janelia-experimental-technology/Rodent-Cylindrical-Treadmill/V1 STYROFOAM TREADMILL/Part Models and Drawings/J010497 CT DRIVE SHAFT Rev -.stp

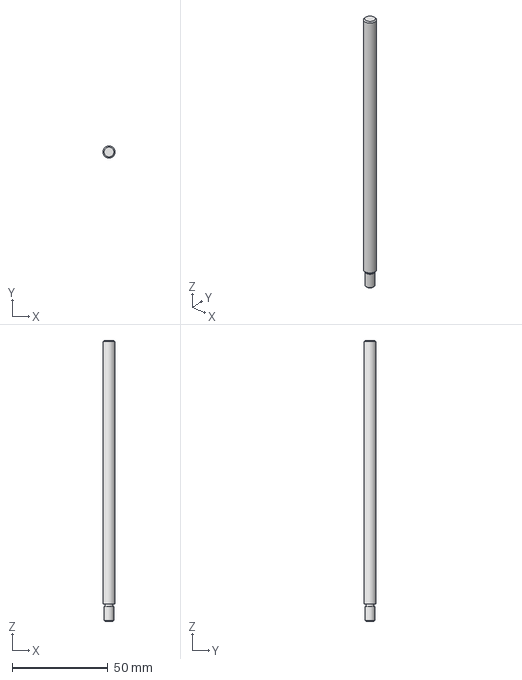
[picture p3: CAD file, 2026-11-08]
V1 STYROFOAM TREADMILL/Part Models and Drawings/J010497 CT DRIVE SHAFT Rev -.stp
6.34 x 6.35 x 146.8 mm
