janelia-experimental-technology/Rodent-Cylindrical-Treadmill/V2 METAL PRINTED TREADMILL/PART MODELS AND DRAWINGS/J010826 CT 9723T11_AI Rev -.stp

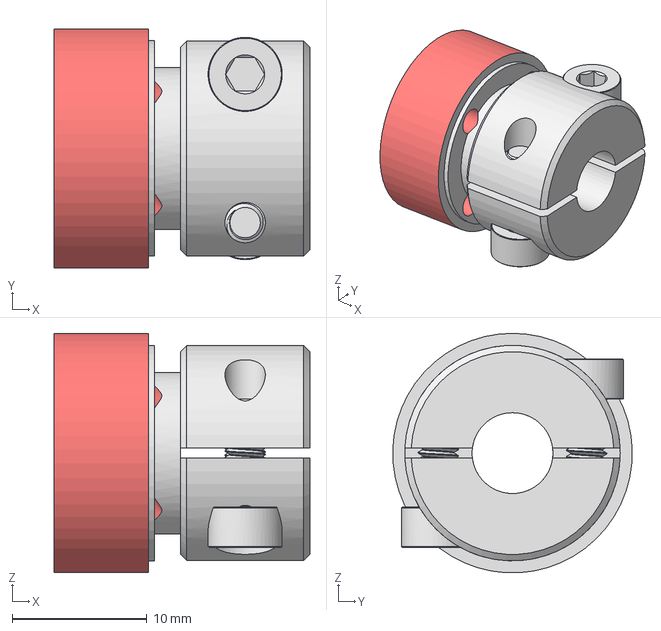
[picture p4: CAD file, 2026-11-08]
V2 METAL PRINTED TREADMILL/PART MODELS AND DRAWINGS/J010826 CT 9723T11_AI Rev -.stp
19.0 x 17.8 x 17.8 mm
