janelia-experimental-technology/Rodent-Cylindrical-Treadmill/V1 STYROFOAM TREADMILL/Part Models and Drawings/J010768 QUICK SWAP CT MOUNT PLATE Rev -.stp

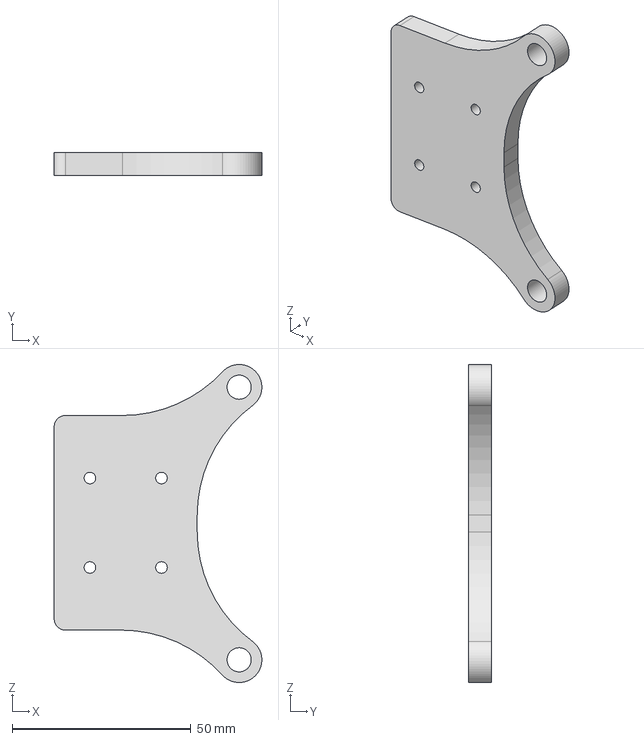
[picture p6: CAD file, 2024-11-06]
V1 STYROFOAM TREADMILL/Part Models and Drawings/J010768 QUICK SWAP CT MOUNT PLATE Rev -.stp
58.1 x 6.35 x 88.9 mm
