janelia-experimental-technology/Rodent-Cylindrical-Treadmill/V1 STYROFOAM TREADMILL/Part Models and Drawings/J010514 CT FOAM WHEEL Rev -.stp

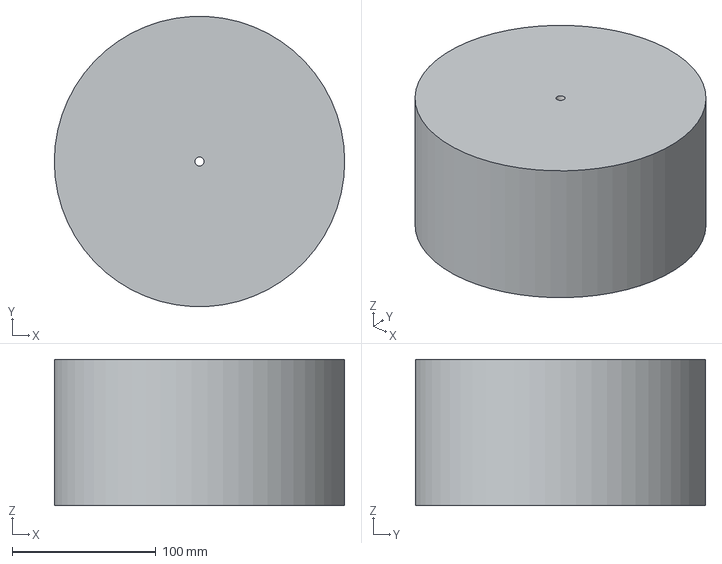
[picture p7: CAD file, 2024-11-05]
V1 STYROFOAM TREADMILL/Part Models and Drawings/J010514 CT FOAM WHEEL Rev -.stp
201.9 x 201.6 x 101.6 mm
