janelia-experimental-technology/Rodent-Cylindrical-Treadmill/(list of files, cad)

Other CAD files:
V2 METAL PRINTED TREADMILL/ASSEMBLY MODELS AND DRAWINGS/CT MPRINTED QUICK SWAP XZ ADJUST.stp
V1 STYROFOAM TREADMILL/Part Models and Drawings/J010764 CT WIDE SIDE PLATE Rev -.stp
V1 STYROFOAM TREADMILL/Part Models and Drawings/J010764 CT WIDE SIDE PLATE Rev -.dxf
V1 STYROFOAM TREADMILL/Part Models and Drawings/J010768 QUICK SWAP CT MOUNT PLATE Rev -.dxf
