janelia-experimental-technology/Rodent-Cylindrical-Treadmill/V2 METAL PRINTED TREADMILL/PART MODELS AND DRAWINGS/J010826 CT 9723T11_AI Rev -.pdf

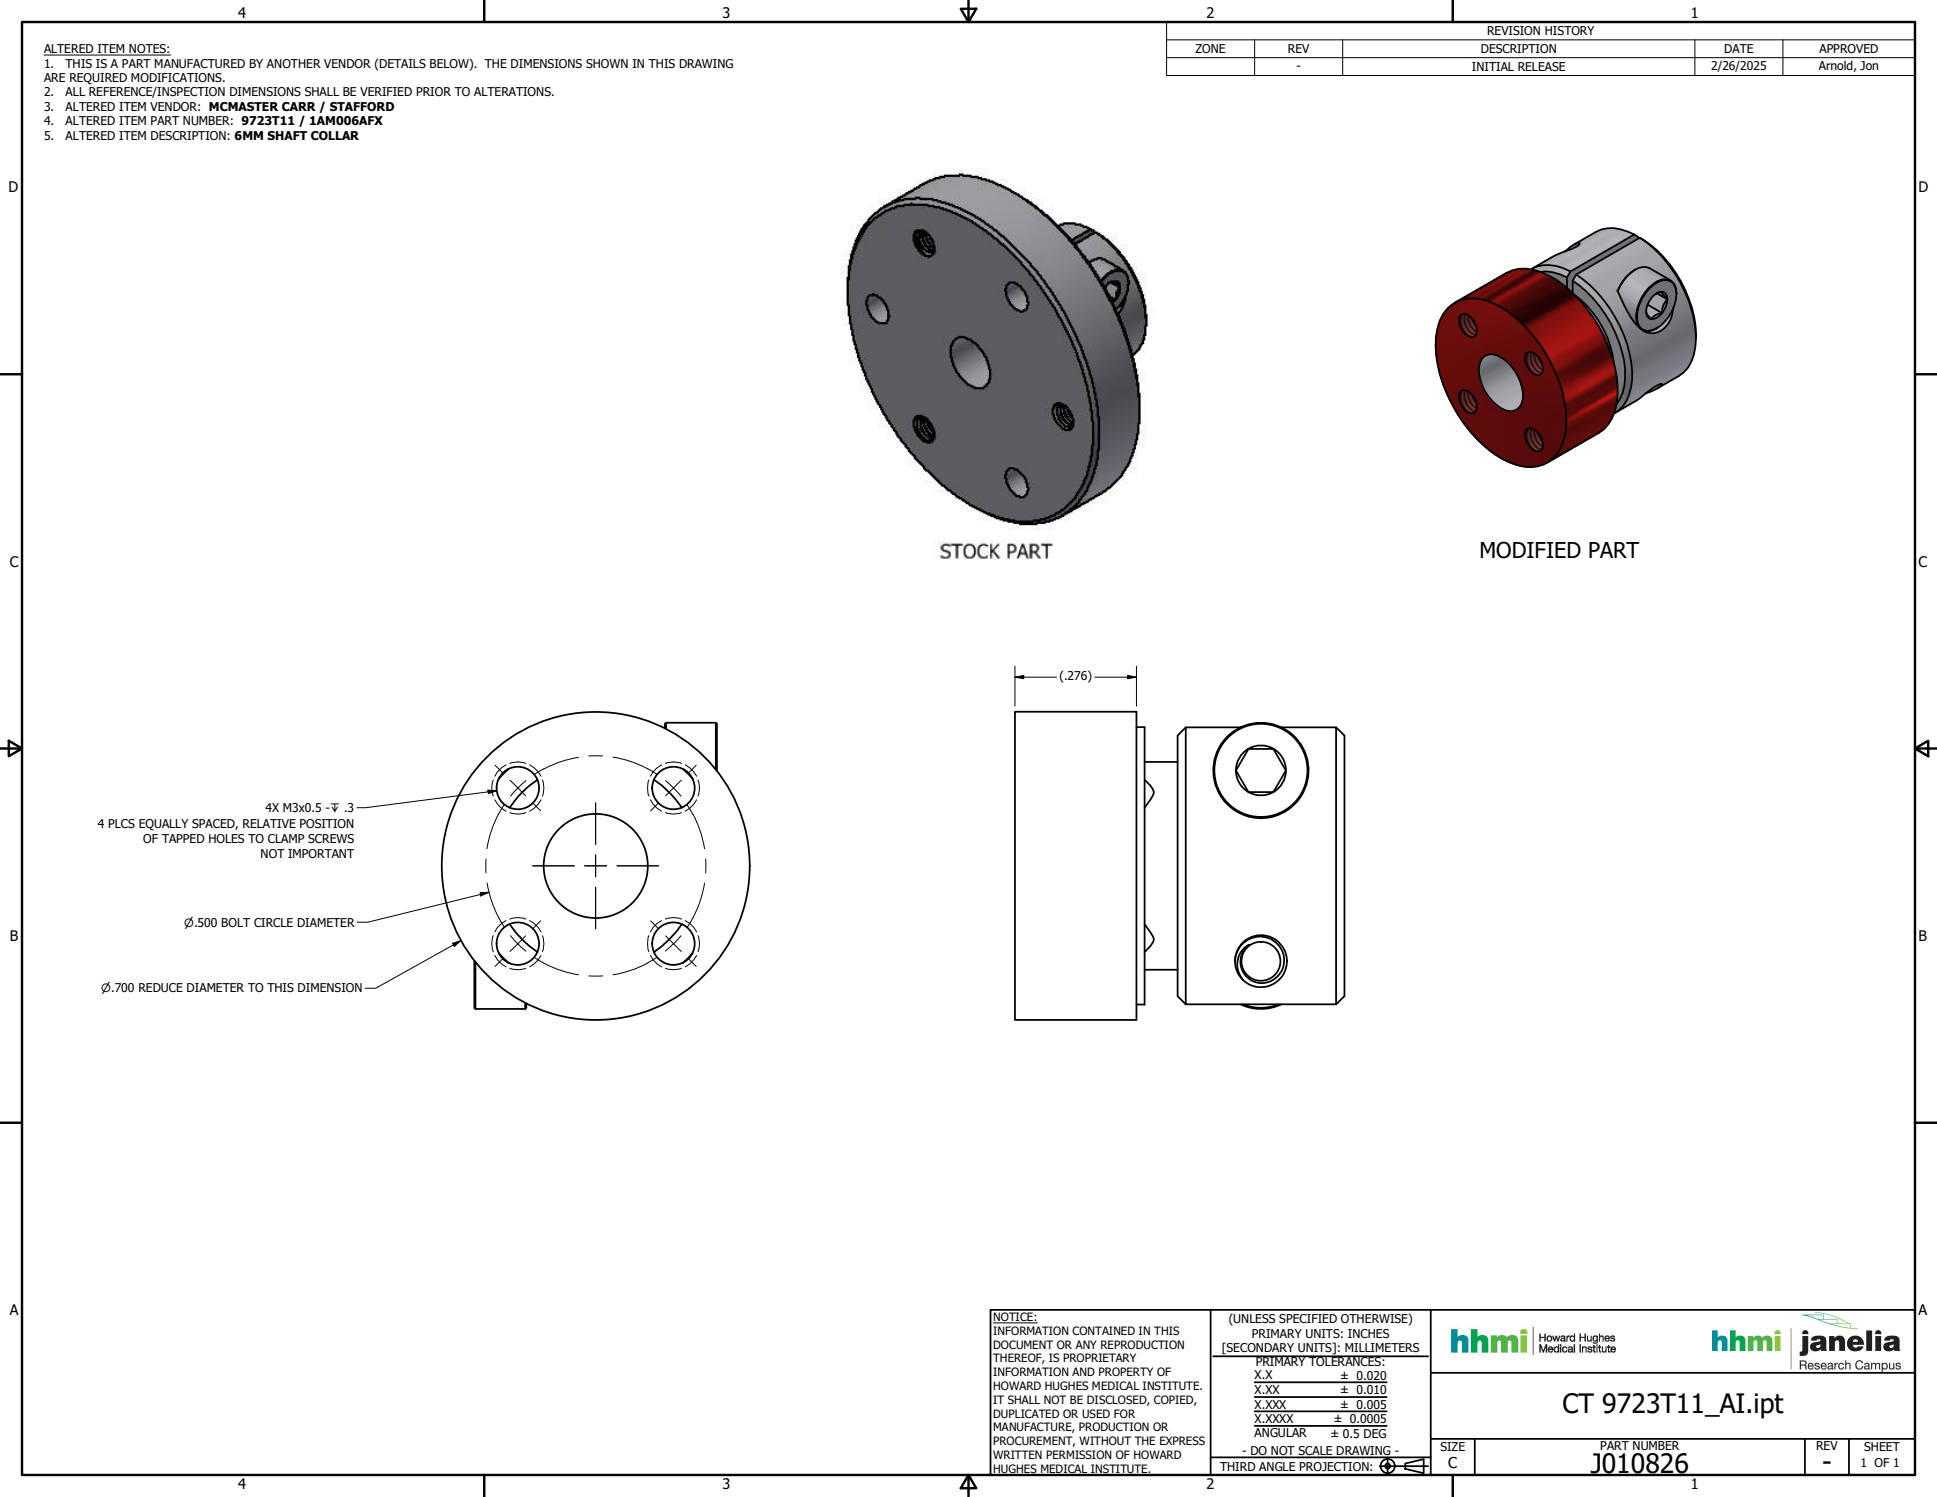
[picture p8: page 1]
MODIFIED PART; PART NUMBER; 1 OF 1 THIRD ANGLE PROJECTION:; ± 0.020 ± 0.010 ± 0.005 ± 0.0005 ± 0.5 DEG; CT 9723T11_AI.ipt; REVISION HISTORY; NOT IMPORTANT

ALTERED ITEM NOTES:
1. THIS IS A PART MANUFACTURED BY ANOTHER VENDOR (DETAILS BELOW). THE DIMENSIONS SHOWN IN THIS DRAWING
ARE REQUIRED MODIFICATIONS.
2. ALL REFERENCE/INSPECTION DIMENSIONS SHALL BE VERIFIED PRIOR TO ALTERATIONS.
3. ALTERED ITEM VENDOR: MCMASTER CARR / STAFFORD
4. ALTERED ITEM PART NUMBER: 9723T11 / 1AM006AFX
5. ALTERED ITEM DESCRIPTION: 6MM SHAFT COLLAR

ZONE | REV | DESCRIPTION | DATE | APPROVED

- | INITIAL RELEASE | 2/26/2025 | Arnold, Jon

4 PLCS EQUALLY SPACED, RELATIVE POSITION

OF TAPPED HOLES TO CLAMP SCREWS

⌀.500 BOLT CIRCLE DIAMETER

⌀.700 REDUCE DIAMETER TO THIS DIMENSION

NOTICE:
INFORMATION CONTAINED IN THIS
DOCUMENT OR ANY REPRODUCTION
THEREOF, IS PROPRIETARY
INFORMATION AND PROPERTY OF
HOWARD HUGHES MEDICAL INSTITUTE.
IT SHALL NOT BE DISCLOSED, COPIED,
DUPLICATED OR USED FOR
MANUFACTURE, PRODUCTION OR
PROCUREMENT, WITHOUT THE EXPRESS
WRITTEN PERMISSION OF HOWARD
HUGHES MEDICAL INSTITUTE.

(UNLESS SPECIFIED OTHERWISE)
PRIMARY UNITS: INCHES
[SECONDARY UNITS]: MILLIMETERS
PRIMARY TOLERANCES:
X.XXX
X.XXXX
ANGULAR
- DO NOT SCALE DRAWING -
