janelia-experimental-technology/Rodent-Cylindrical-Treadmill/Part Models and Drawings/J010768 QUICK SWAP CT MOUNT PLATE Rev -.pdf

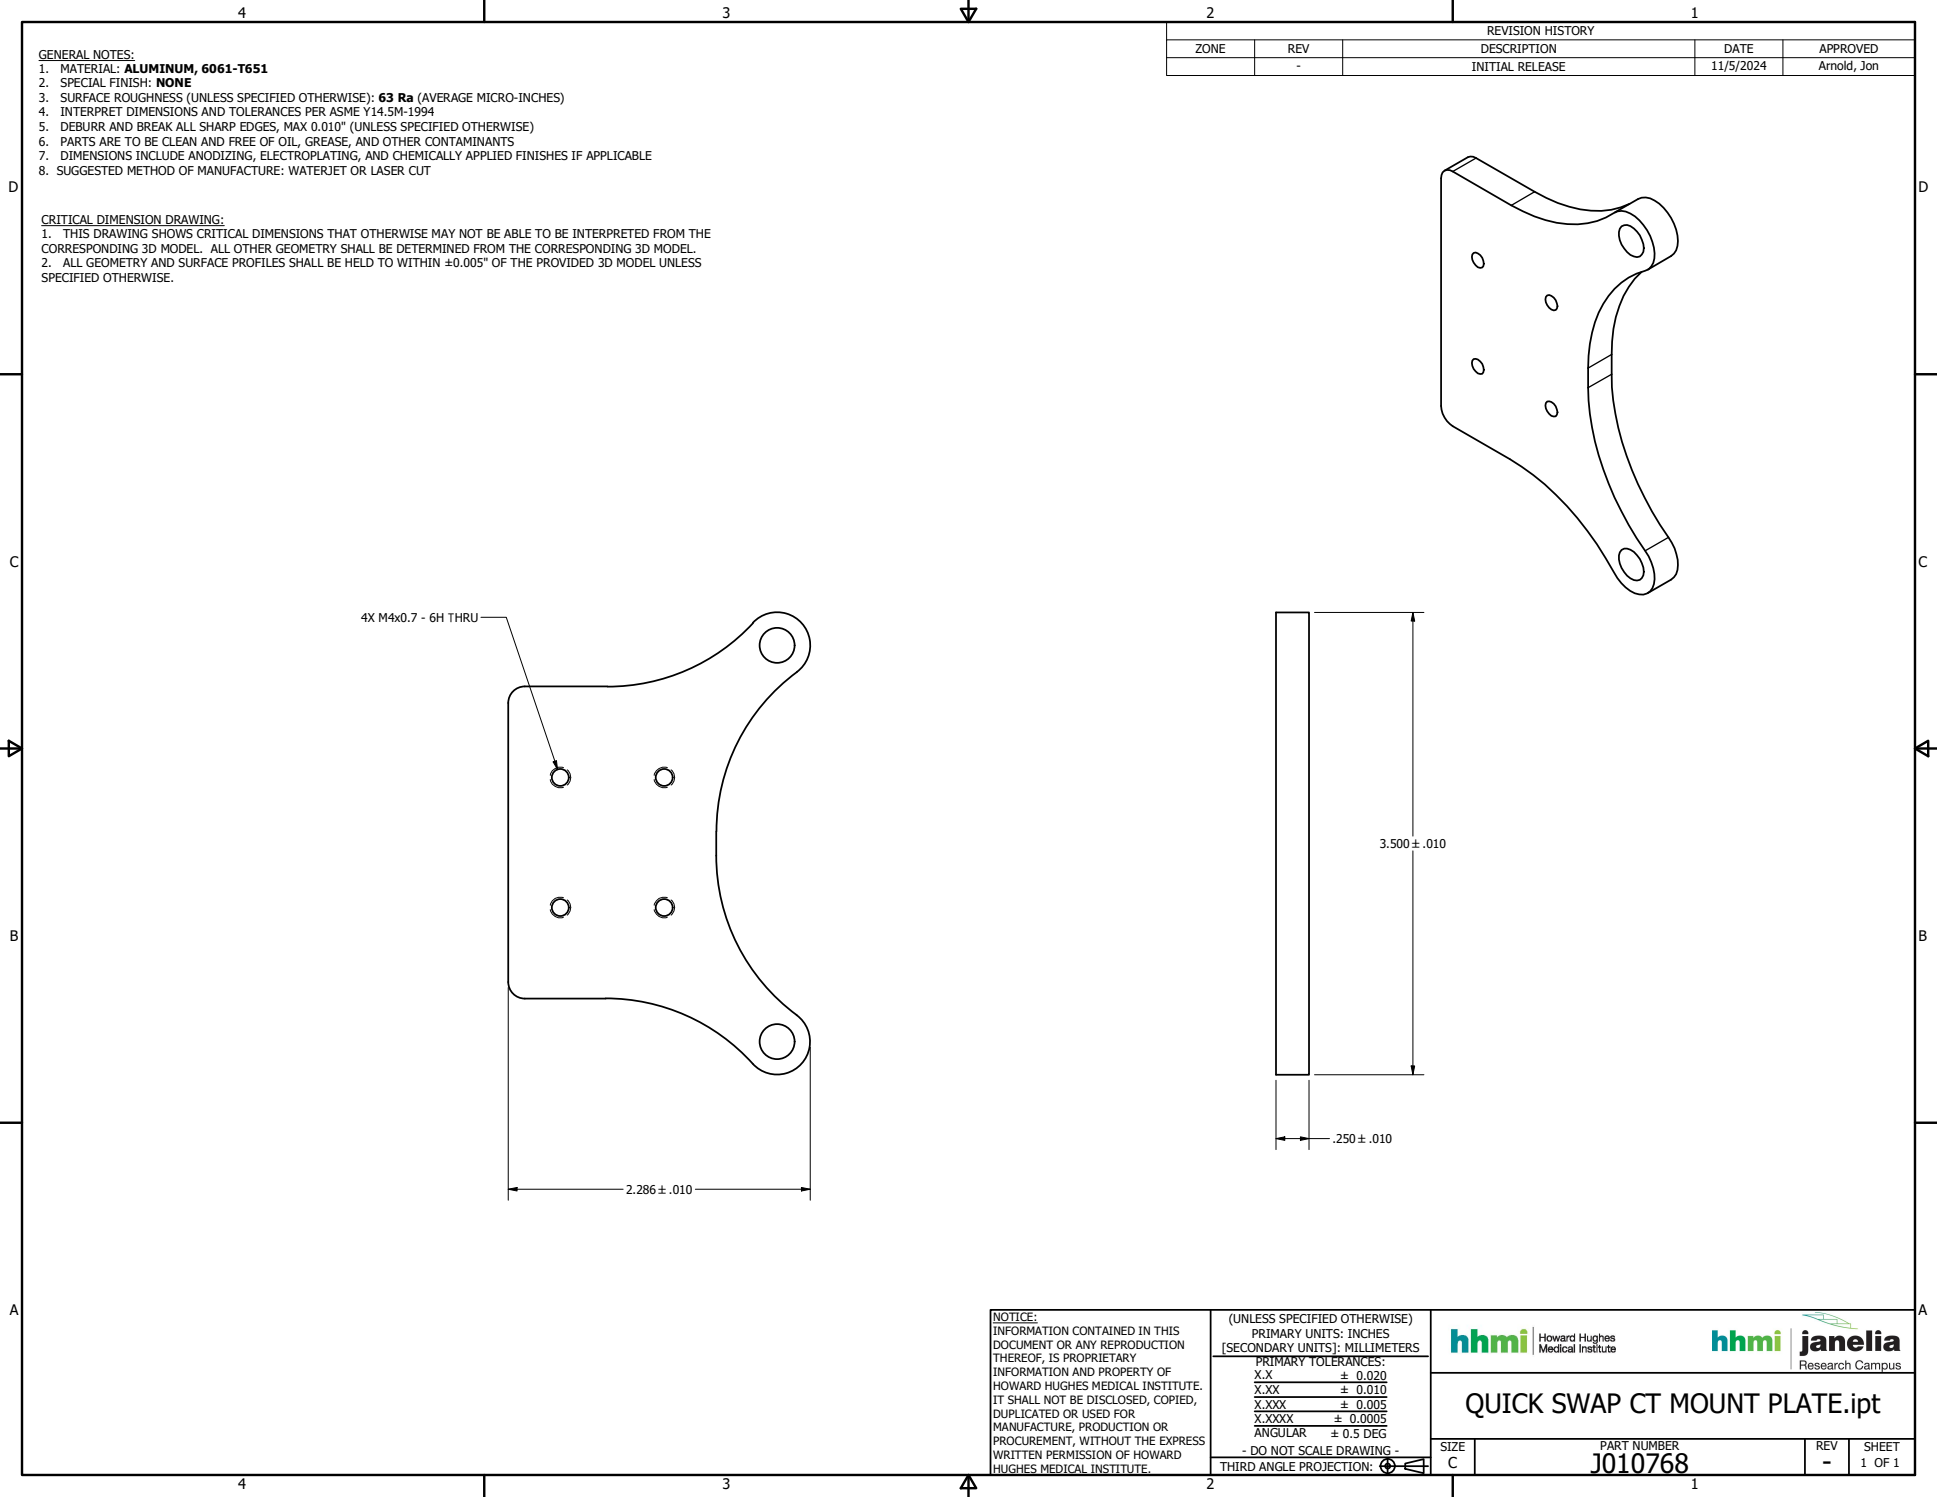
[picture p10: page 1]
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

ZONE | REV | DESCRIPTION | DATE | APPROVED

GENERAL NOTES:
1. MATERIAL: ALUMINUM, 6061-T651
2. SPECIAL FINISH: NONE
3. SURFACE ROUGHNESS (UNLESS SPECIFIED OTHERWISE): 63 Ra (AVERAGE MICRO-INCHES)
4. INTERPRET DIMENSIONS AND TOLERANCES PER ASME Y14.5M-1994
5. DEBURR AND BREAK ALL SHARP EDGES, MAX 0.010" (UNLESS SPECIFIED OTHERWISE)
6. PARTS ARE TO BE CLEAN AND FREE OF OIL, GREASE, AND OTHER CONTAMINANTS
7. DIMENSIONS INCLUDE ANODIZING, ELECTROPLATING, AND CHEMICALLY APPLIED FINISHES IF APPLICABLE
8. SUGGESTED METHOD OF MANUFACTURE: WATERJET OR LASER CUT

- | INITIAL RELEASE | 11/5/2024 | Arnold, Jon

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

QUICK SWAP CT MOUNT PLATE.ipt
