janelia-experimental-technology/Rodent-Cylindrical-Treadmill/V1 STYROFOAM TREADMILL/Part Models and Drawings/J010514 CT FOAM WHEEL Rev -.pdf

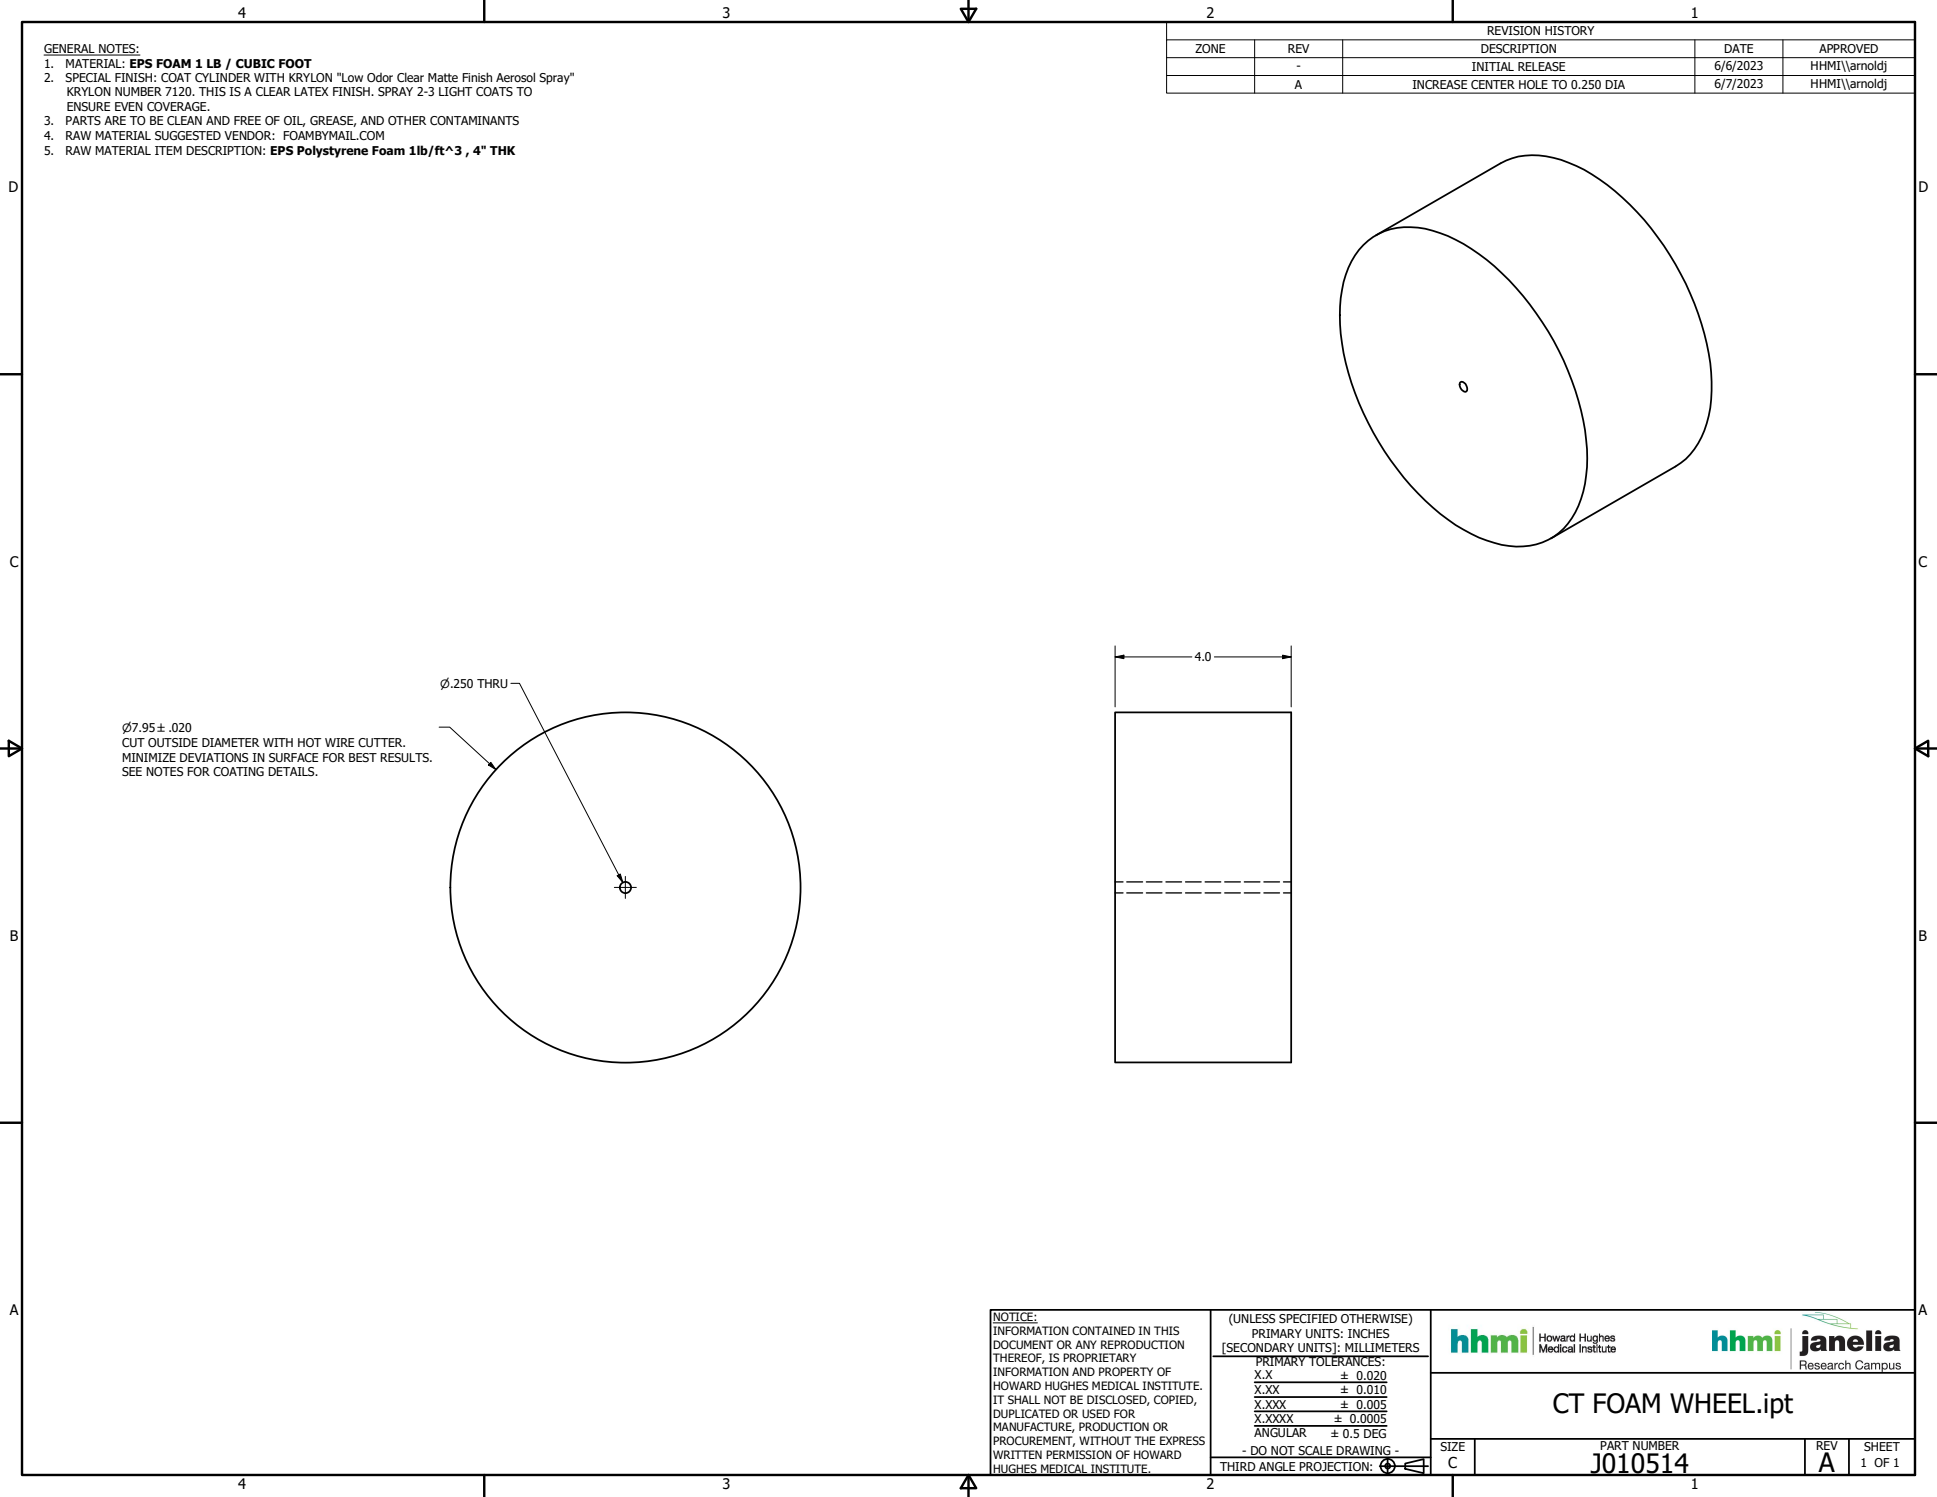
[picture p11: page 1]
PART NUMBER; 1 OF 1 THIRD ANGLE PROJECTION:; ± 0.020 ± 0.010 ± 0.005 ± 0.0005 ± 0.5 DEG; REVISION HISTORY; ⌀.250 THRU

GENERAL NOTES:
1. MATERIAL: EPS FOAM 1 LB / CUBIC FOOT
2. SPECIAL FINISH: COAT CYLINDER WITH KRYLON "Low Odor Clear Matte Finish Aerosol Spray"
KRYLON NUMBER 7120. THIS IS A CLEAR LATEX FINISH. SPRAY 2-3 LIGHT COATS TO
ENSURE EVEN COVERAGE.
3. PARTS ARE TO BE CLEAN AND FREE OF OIL, GREASE, AND OTHER CONTAMINANTS
4. RAW MATERIAL SUGGESTED VENDOR: FOAMBYMAIL.COM
5. RAW MATERIAL ITEM DESCRIPTION: EPS Polystyrene Foam 1lb/ft^3 , 4" THK

ZONE | REV | DESCRIPTION | DATE | APPROVED

- | INITIAL RELEASE | 6/6/2023 | HHMI\\arnoldj
A | INCREASE CENTER HOLE TO 0.250 DIA | 6/7/2023 | HHMI\\arnoldj

CUT OUTSIDE DIAMETER WITH HOT WIRE CUTTER.
MINIMIZE DEVIATIONS IN SURFACE FOR BEST RESULTS.
SEE NOTES FOR COATING DETAILS.

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

CT FOAM WHEEL.ipt
