janelia-experimental-technology/Rodent-Cylindrical-Treadmill/V1 STYROFOAM TREADMILL/Part Models and Drawings/J010497 CT DRIVE SHAFT Rev -.pdf

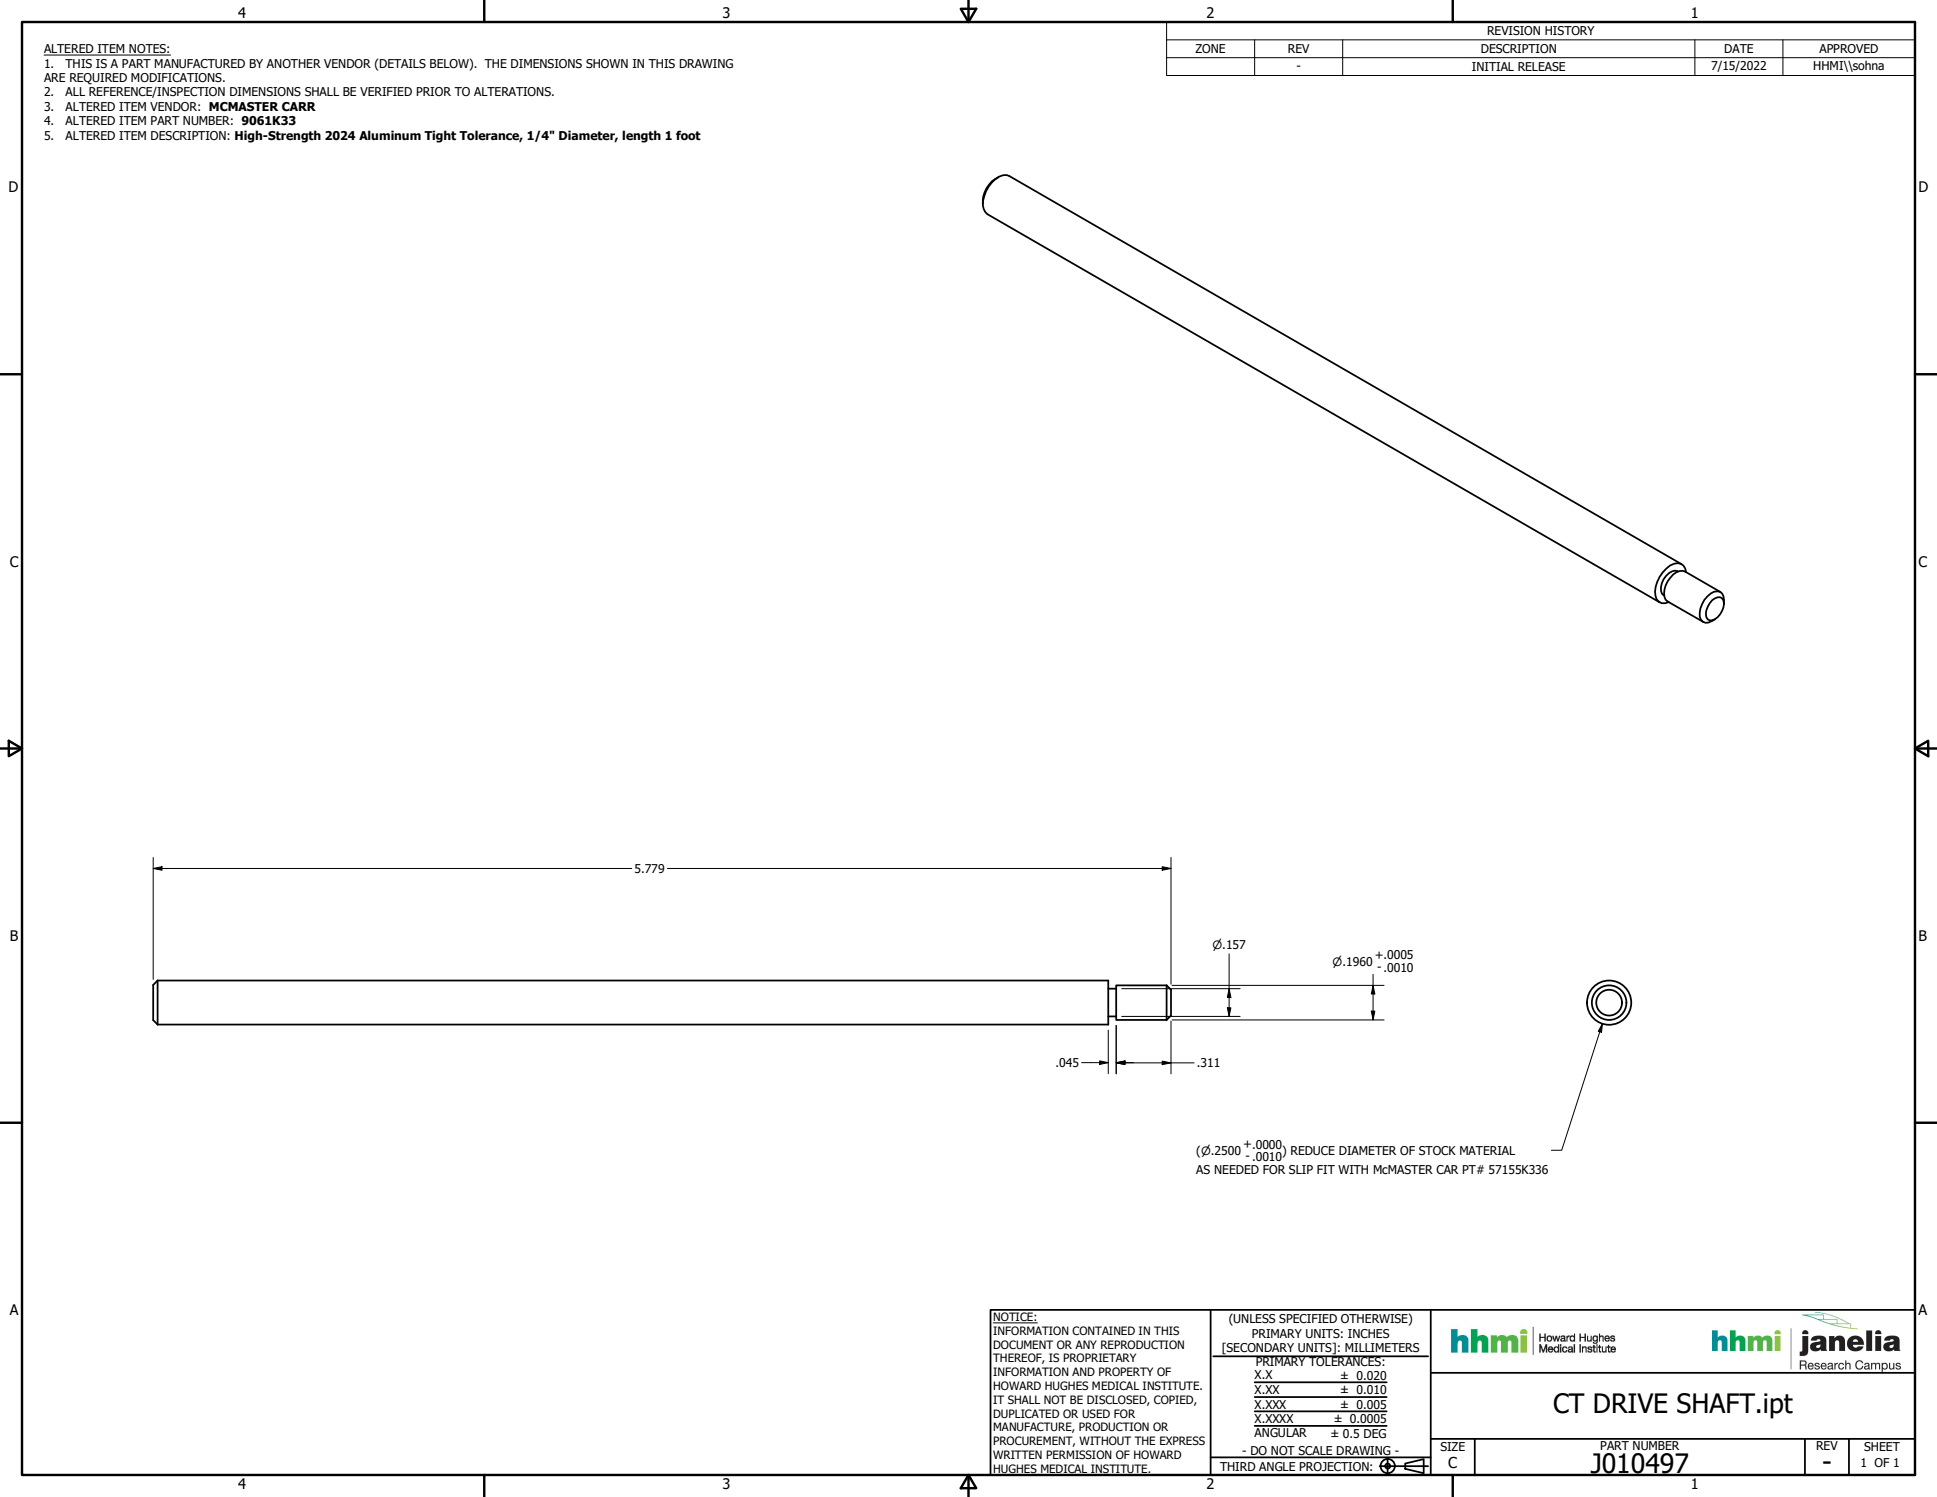
[picture p12: page 1]
PART NUMBER; 1 OF 1 THIRD ANGLE PROJECTION:; ± 0.020 ± 0.010 ± 0.005 ± 0.0005 ± 0.5 DEG; REVISION HISTORY; ) REDUCE DIAMETER OF STOCK MATERIAL

ALTERED ITEM NOTES:
1. THIS IS A PART MANUFACTURED BY ANOTHER VENDOR (DETAILS BELOW). THE DIMENSIONS SHOWN IN THIS DRAWING
ARE REQUIRED MODIFICATIONS.
2. ALL REFERENCE/INSPECTION DIMENSIONS SHALL BE VERIFIED PRIOR TO ALTERATIONS.
3. ALTERED ITEM VENDOR: MCMASTER CARR
4. ALTERED ITEM PART NUMBER: 9061K33
5. ALTERED ITEM DESCRIPTION: High-Strength 2024 Aluminum Tight Tolerance, 1/4" Diameter, length 1 foot

ZONE | REV | DESCRIPTION | DATE | APPROVED

- | INITIAL RELEASE | 7/15/2022 | HHMI\\sohna

AS NEEDED FOR SLIP FIT WITH McMASTER CAR PT# 57155K336

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

CT DRIVE SHAFT.ipt
